CREPP-PLOEMEUR/Projet_motogodille/README.md

<!--# Motogodille -->
<!--$ Freecad-->
<!--$ C++ -->
<!--% Un projet de motorisation d'annexe de bateau -->

# Projet de motogodille

Un projet de motorisation d'annexe de bateau.

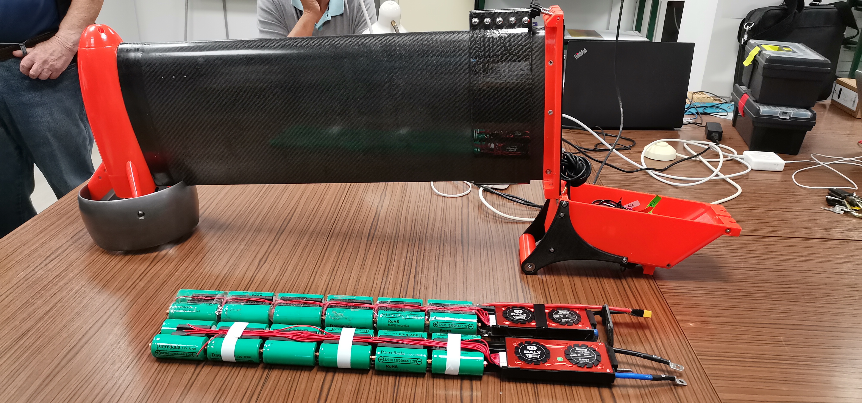
[picture p1: Images/1.jpg]
