CREPP-PLOEMEUR/Projet_motogodille/V0_prototype/schéma_BMS_32700-controleur_julien.pptx

Prise
chargeur

+

+

32700

32700

32700

32700

32700

BMS 10S 36V

C-

P-

32700

32700

32700

32700

32700

B-

+

Contrôleur julien
36V 30A

Moteur
36V
1500W
(42A)

Bouton
Inverseur de
rotation

Potentiomètre
variateur
vitesse
