CREPP-PLOEMEUR/Projet_motogodille/V0_prototype/schéma_BMS_32700.pptx

I 0 II

88.8

+

Contrôleur 36V 30A

+

Moteur
36V
1500W
(42A)

32700

32700

32700

32700

32700

32700

32700

32700

32700

+

+

32700

BMS 10S 36V
