CREPP-PLOEMEUR/Projet_motogodille/V0_prototype/schéma_BMS.pdf

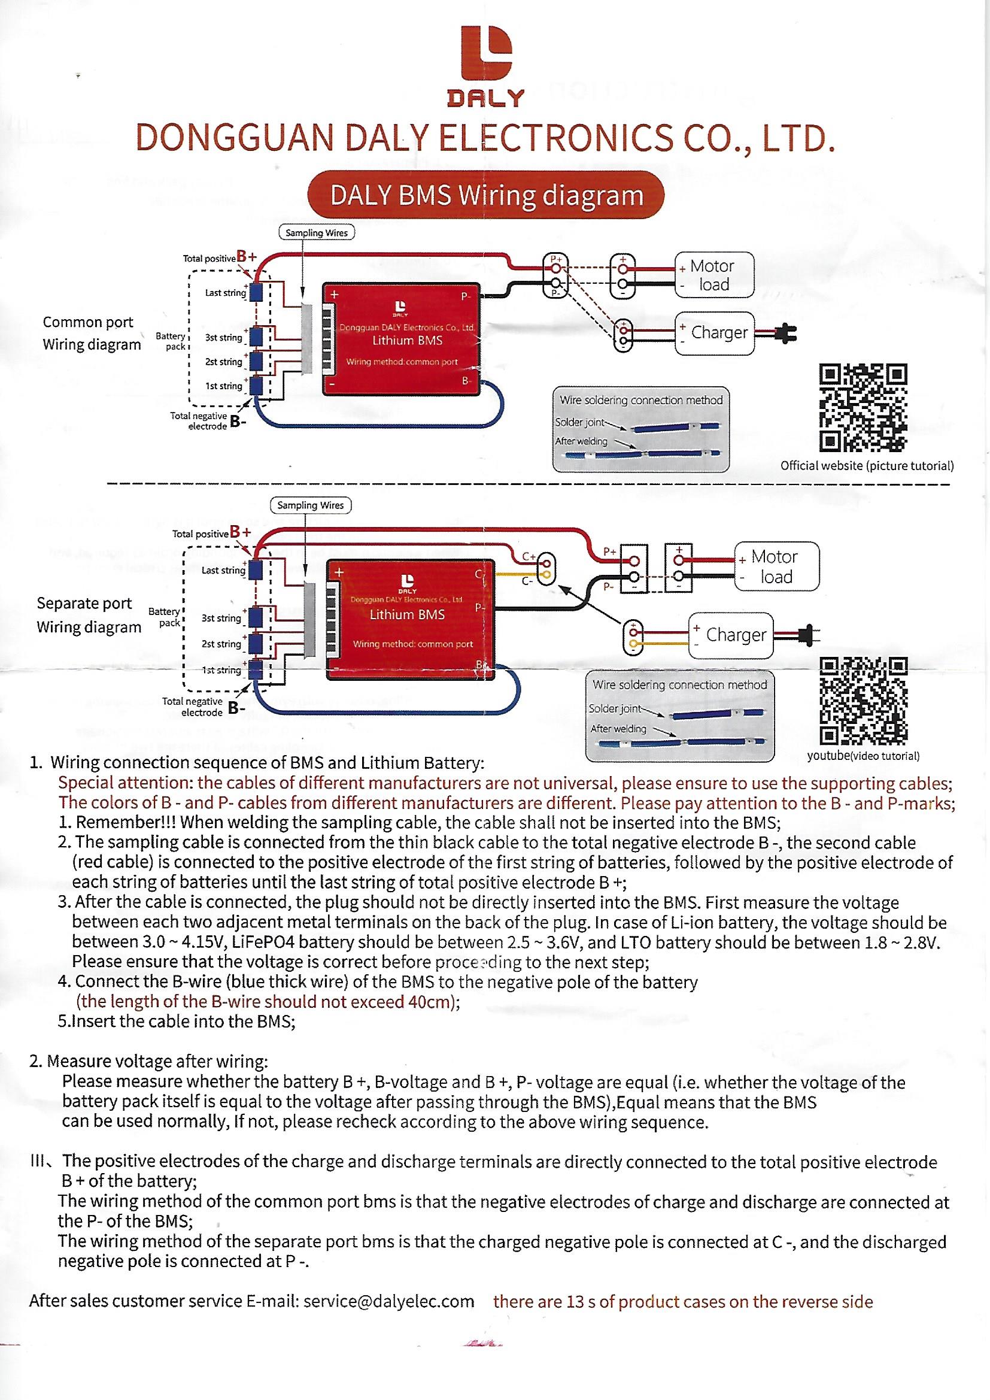
[picture p2: page 1]
