CREPP-PLOEMEUR/Projet_motogodille/V1/photo_video/IMG_5900.jpg

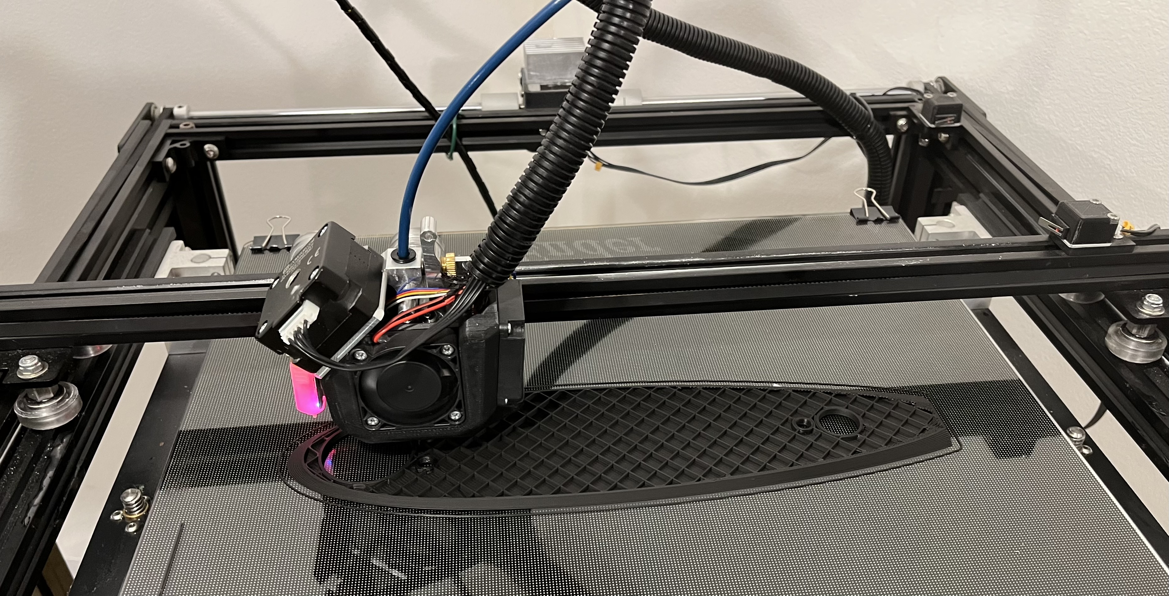
V1/photo_video/IMG_5900.jpg
