CREPP-PLOEMEUR/Projet_motogodille/V1/photo_video/IMG_5931.jpg

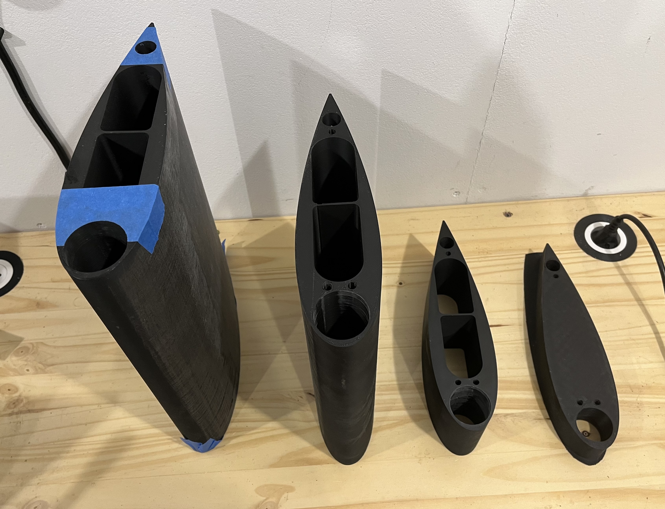
V1/photo_video/IMG_5931.jpg
