CREPP-PLOEMEUR/Projet_motogodille/V1/photo_video/IMG_5932.jpg

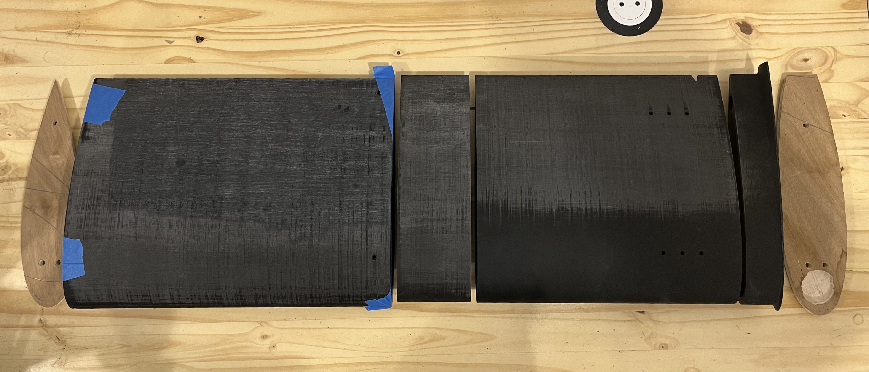
V1/photo_video/IMG_5932.jpg
