CREPP-PLOEMEUR/Projet_motogodille/V1/photo_video/IMG_5934.jpg

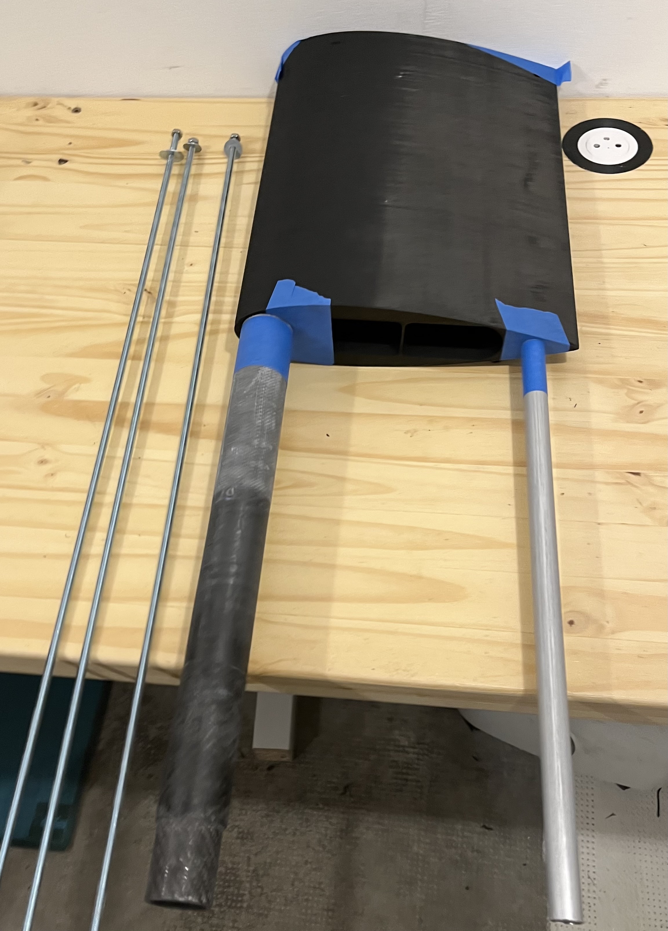
V1/photo_video/IMG_5934.jpg
