CREPP-PLOEMEUR/Projet_motogodille/V1/photo_video/IMG_5938.jpg

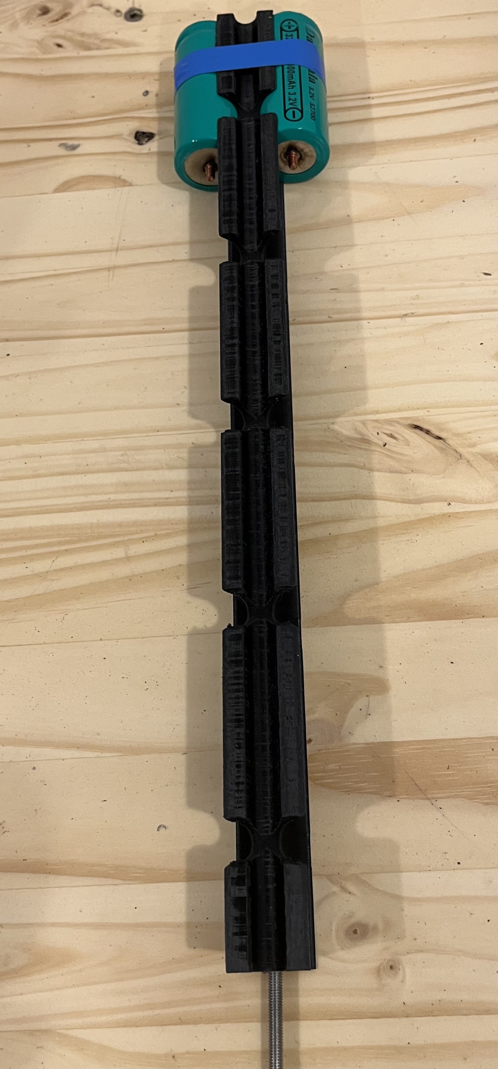
V1/photo_video/IMG_5938.jpg
