CREPP-PLOEMEUR/Projet_motogodille/V1/photo_video/IMG_5939.jpg

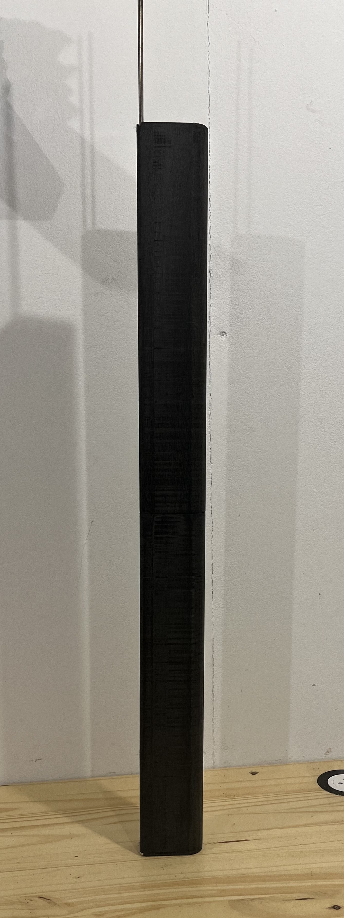
V1/photo_video/IMG_5939.jpg
