CREPP-PLOEMEUR/Projet_motogodille/V1/photo_video/IMG_5940.jpg

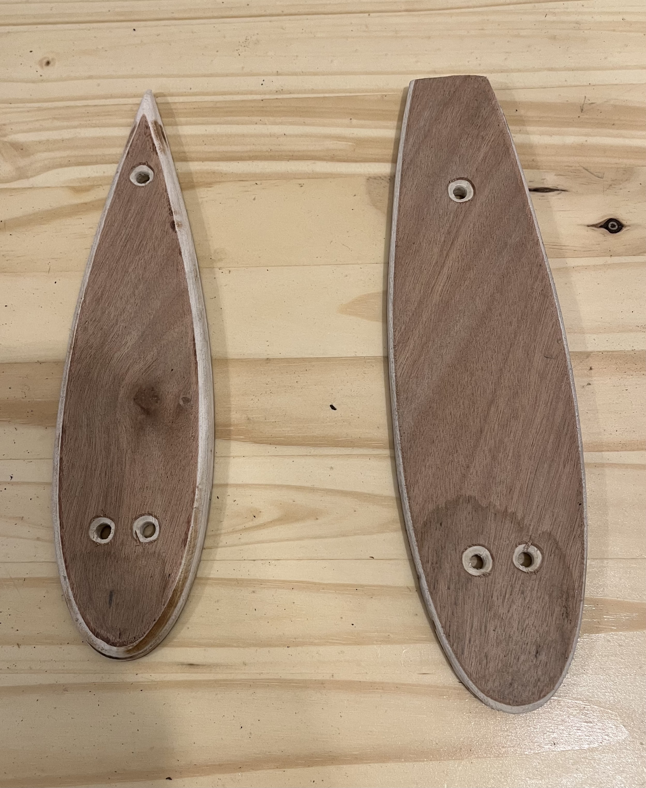
V1/photo_video/IMG_5940.jpg
