CREPP-PLOEMEUR/Projet_motogodille/V1/photo_video/IMG_5956.jpg

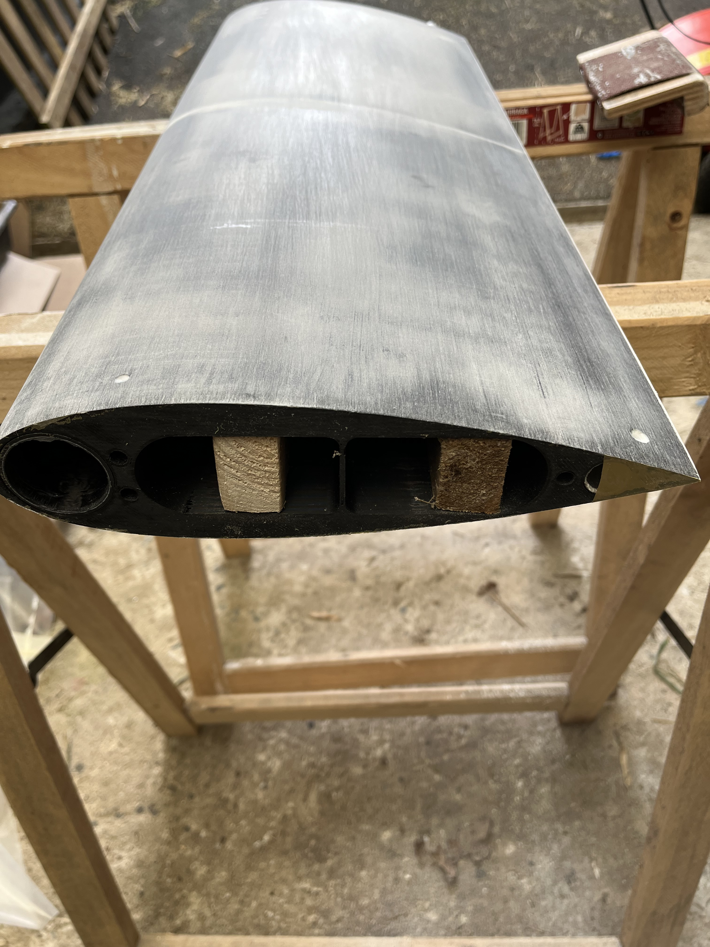
V1/photo_video/IMG_5956.jpg
