CREPP-PLOEMEUR/Projet_motogodille/V1/photo_video/IMG_5966.jpg

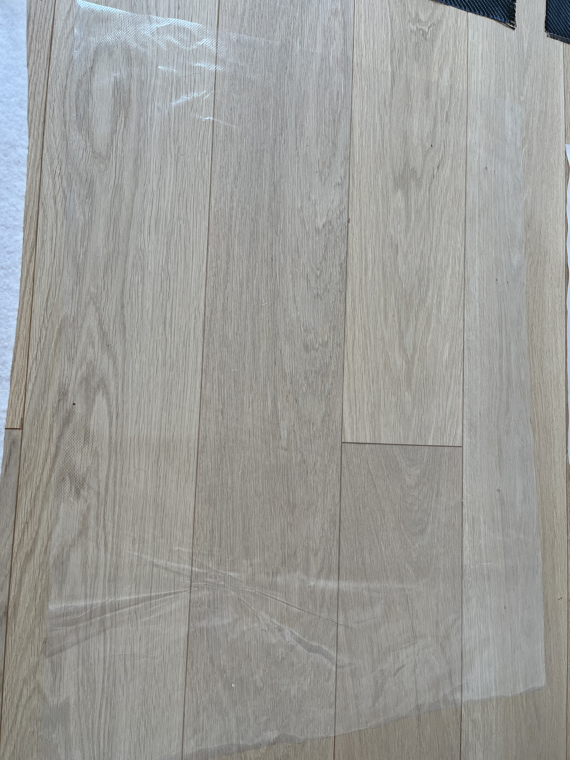
V1/photo_video/IMG_5966.jpg
