CREPP-PLOEMEUR/Projet_motogodille/V1/photo_video/IMG_5988.jpg

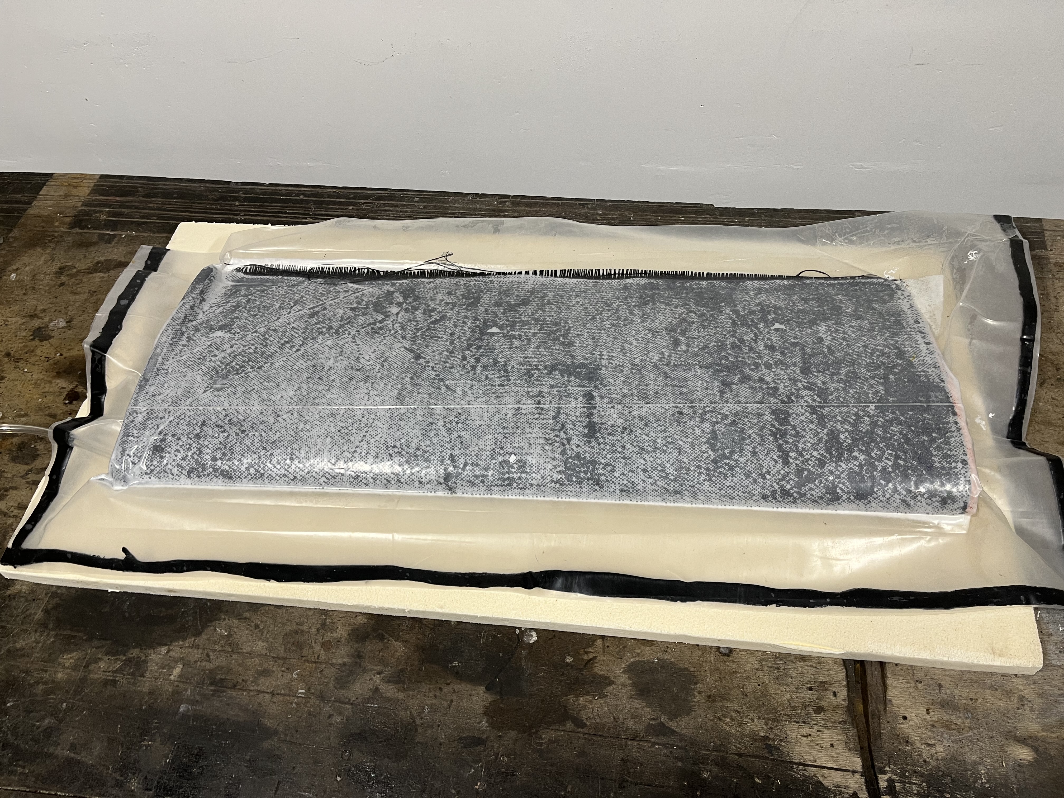
V1/photo_video/IMG_5988.jpg
