CREPP-PLOEMEUR/Projet_motogodille/V1/photo_video/IMG_7340.jpg

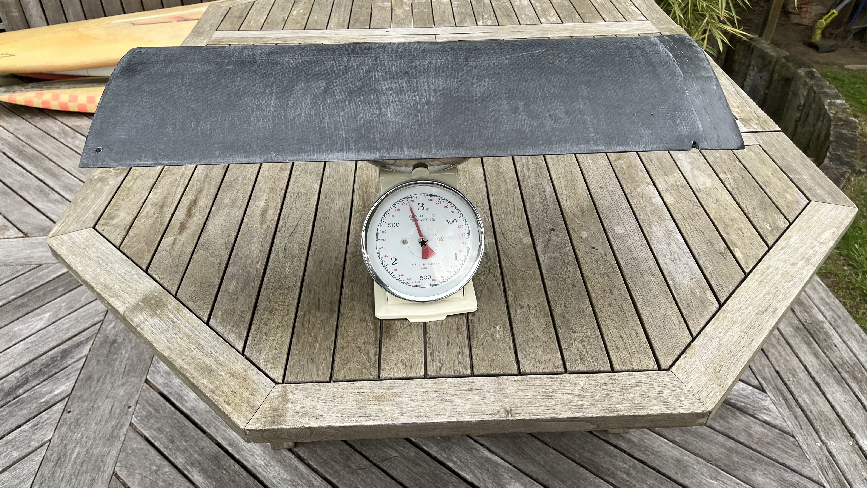
V1/photo_video/IMG_7340.jpg
