CREPP-PLOEMEUR/Projet_motogodille/V1/photo_video/IMG_7341.jpg

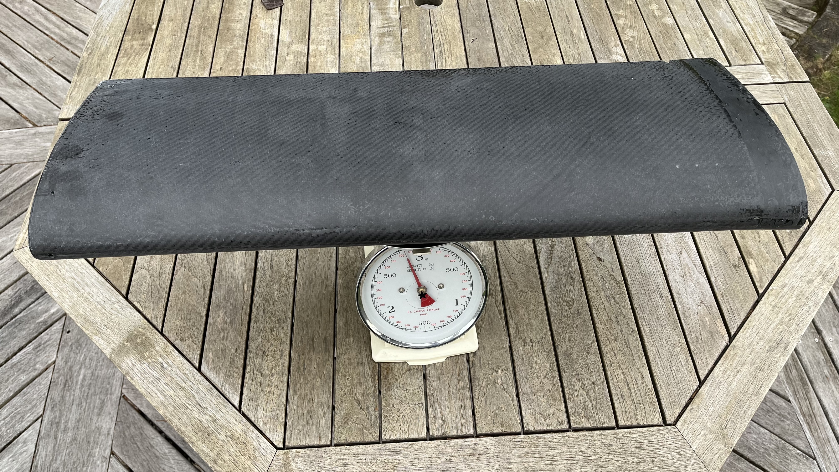
V1/photo_video/IMG_7341.jpg
