CREPP-PLOEMEUR/Projet_motogodille/V1/photo_video/IMG_7342.jpg

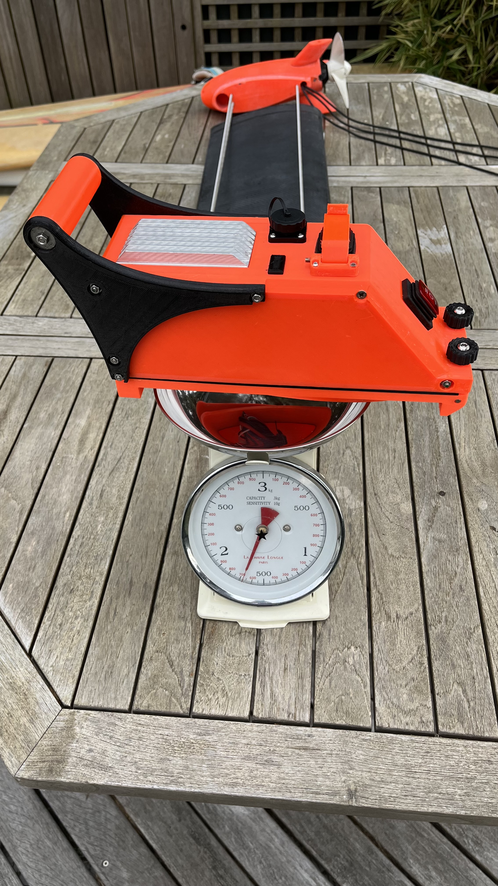
V1/photo_video/IMG_7342.jpg
