CREPP-PLOEMEUR/Projet_motogodille/V1/photo_video/IMG_7344.jpg

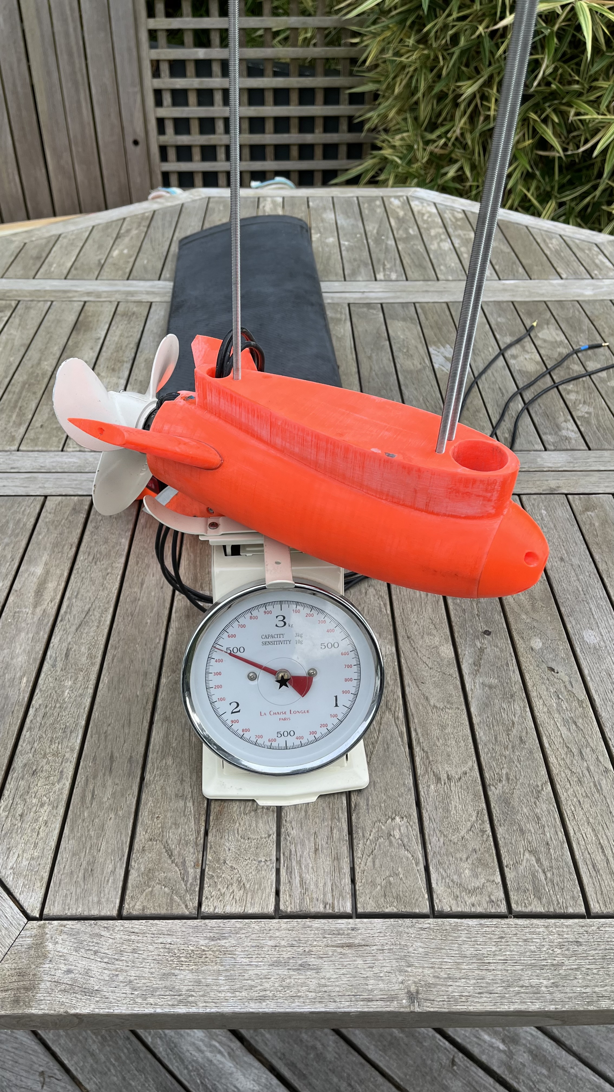
V1/photo_video/IMG_7344.jpg
