CREPP-PLOEMEUR/Projet_motogodille/V1/photo_video/IMG_7346.jpg

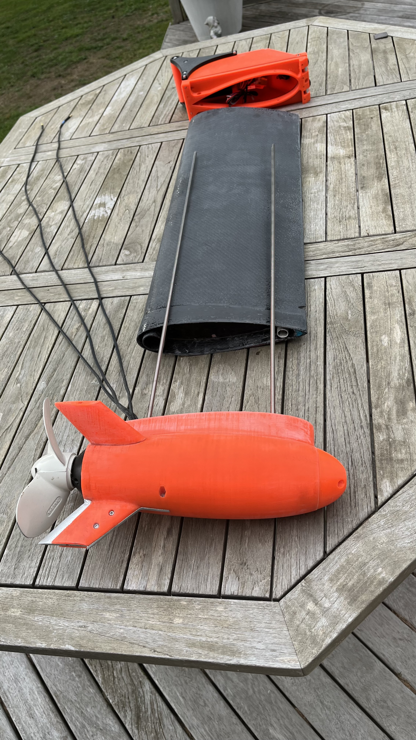
V1/photo_video/IMG_7346.jpg
