CREPP-PLOEMEUR/Projet_motogodille/V1/photo_video/IMG_7348.jpg

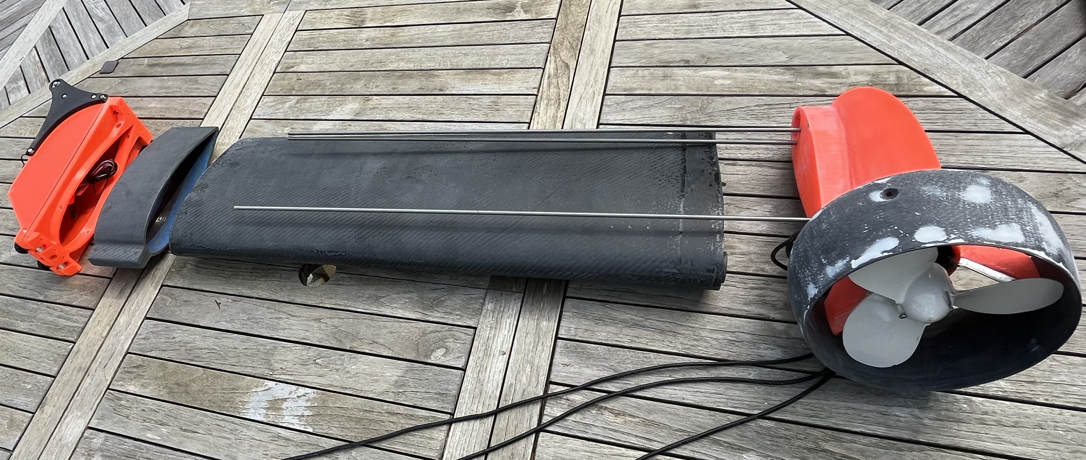
V1/photo_video/IMG_7348.jpg
