CREPP-PLOEMEUR/Projet_motogodille/V1/photo_video/IMG_7349.jpg

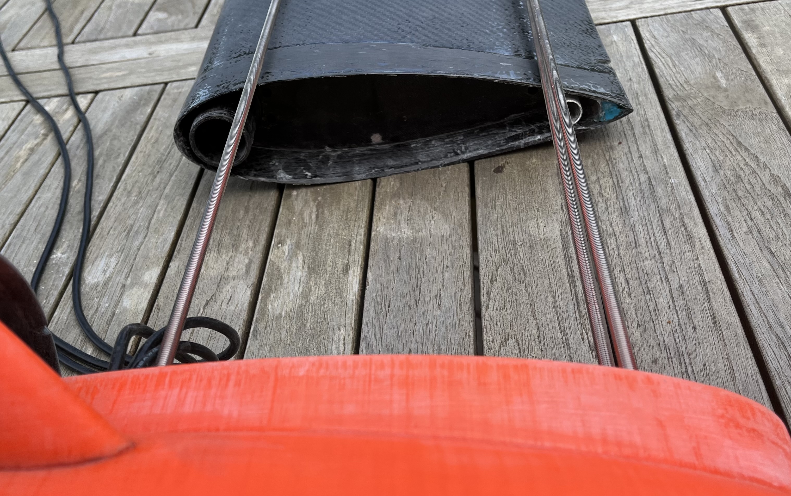
V1/photo_video/IMG_7349.jpg
