CREPP-PLOEMEUR/Projet_motogodille/V1/photo_video/IMG_7351.jpg

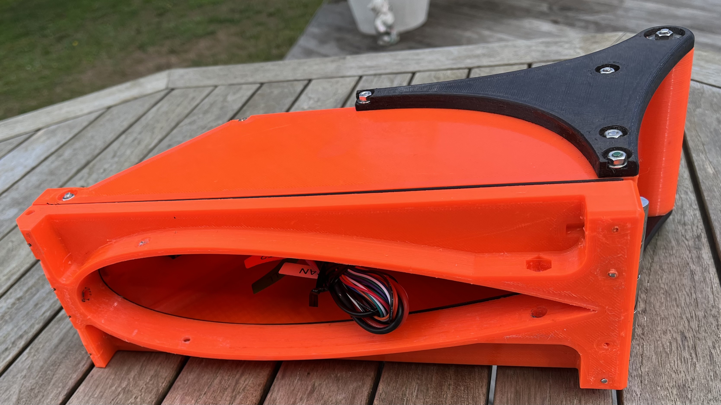
V1/photo_video/IMG_7351.jpg
