CREPP-PLOEMEUR/Projet_motogodille/V1/dossier de conception_nomenclature_pert/schéma_BMS_32700_motogodille_2_V2.pptx

Charge batterie A

+

BMS 12S 36V

P-

B-

+

+

32700

32700

32700

32700

32700

32700

Batterie A

32700

32700

32700

32700

32700

32700

+

+

+

P-

BMS 12S 36V

B-

+

32700

32700

32700

32700

32700

32700

Charge batterie B

Batterie B

+

32700

32700

32700

32700

32700

32700

Moteur
36V
1500W
(60A)

+

Alimentation ext

Contrôleur
40V 100A

Bouton Inverseur de rotation

Potentiomètre
variateur
vitesse
