CREPP-PLOEMEUR/Projet_motogodille/(list of files, cad)

Other CAD files:
V0_prototype/bouchon_vidange_1.FCStd
V1/freecad/motogodille_2_tierce.FCStd
V0_prototype/ressort_rappel.FCStd
V1/freecad/boitier_batterie_BMS_150.FCStd
V0_prototype/rondelle_potentiometre.FCStd
V1/freecad/haut_MTG2_tierce.FCStd
V0_prototype/poignée de gaz_1.FCStd
V0_prototype/tirette.FCStd
V0_prototype/poignée_transport.FCStd
V0_prototype/passe_cable_3.FCStd
V0_prototype/écrou_poignée.FCStd
V0_prototype/rondelle_tirette.FCStd
V0_prototype/flasque_tube_32.FCStd
