CREPP-PLOEMEUR/Projet_motogodille/V1/dossier de conception_nomenclature_pert/schéma_BMS_32700_motogodille_2_V2.pdf

+

-B -

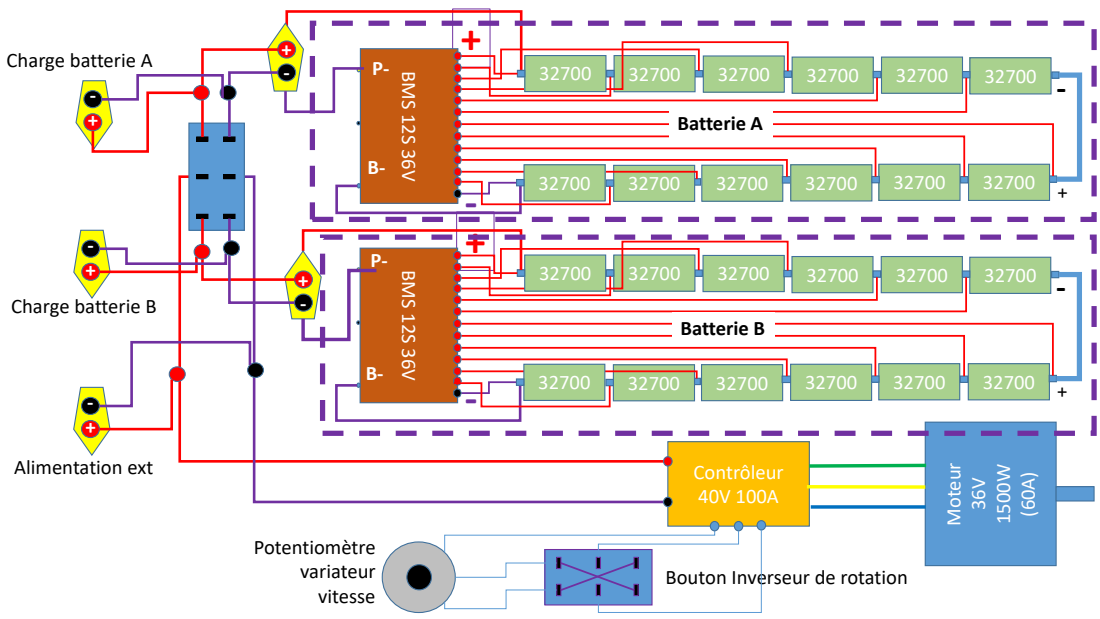
[picture p68: page 1]
Contrôleur 40V 100A; Moteur; BMS 12S 36V; Potentiomètre variateur vitesse; Charge batterie; Batterie A; Batterie B; Alimentation ext +-

Bouton Inverseur de rotation
