CREPP-PLOEMEUR/Projet_motogodille/V0_prototype/schéma_BMS_32700-controleur_julien.pdf

+

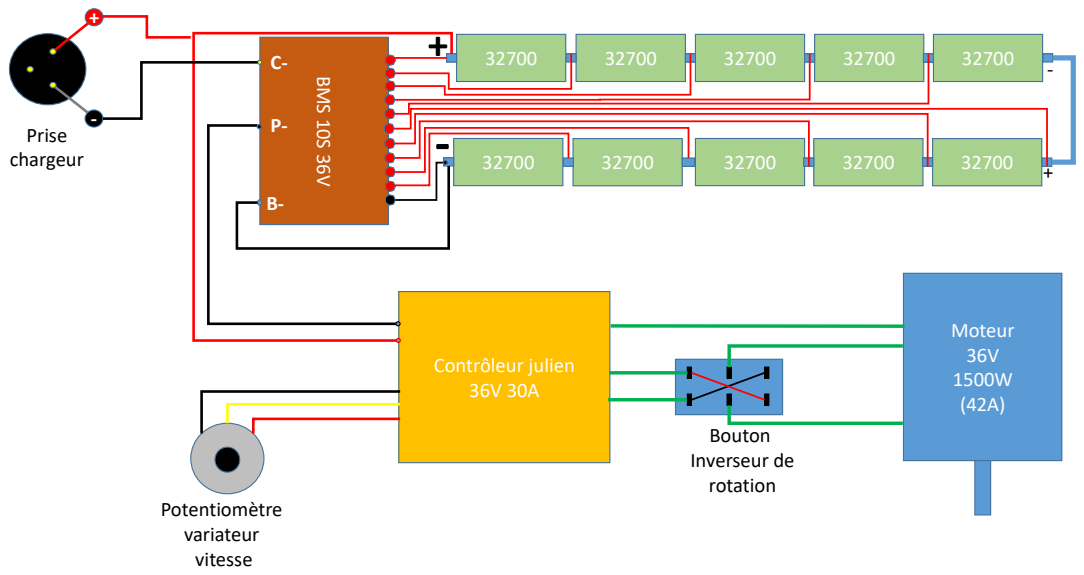
[picture p69: page 1]
Contrôleur julien 36V 30A; Moteur 36V 1500W (42A); BMS 10S 36V; Bouton Inverseur de rotation; Prise chargeur; Potentiomètre variateur vitesse
