CREPP-PLOEMEUR/Projet_motogodille/V1/dossier de conception_nomenclature_pert/fixation_tableau_MTG2.pdf

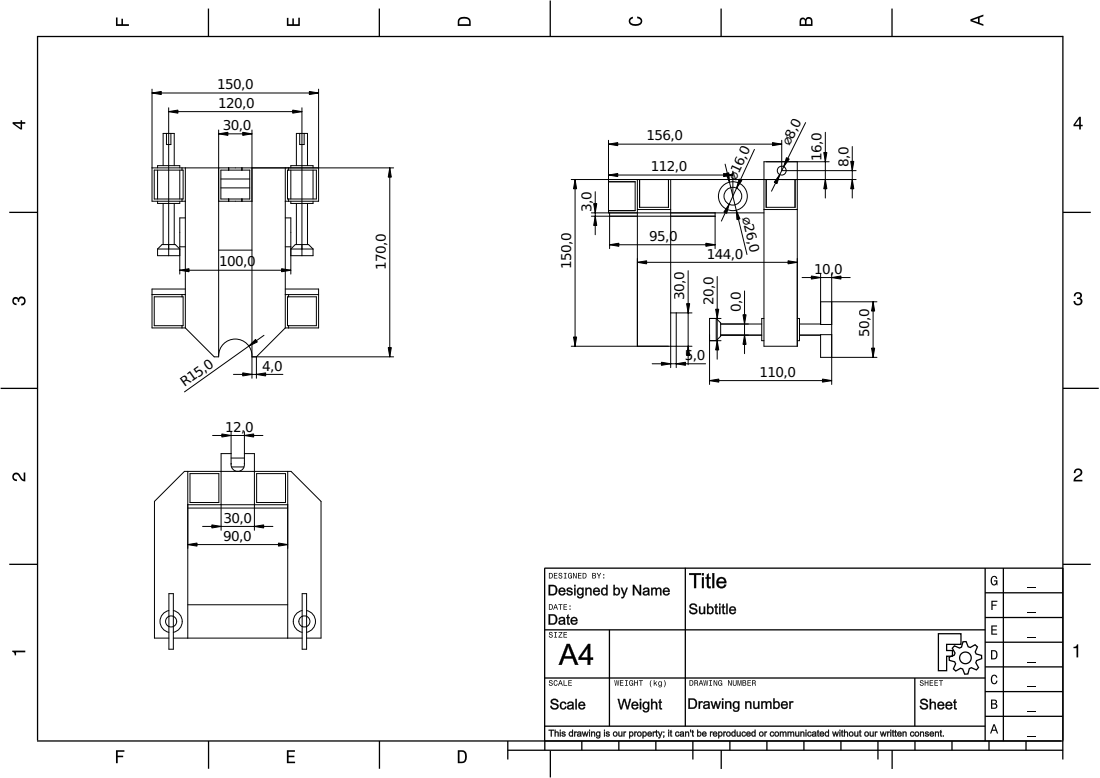
[picture p70: page 1]
