CREPP-PLOEMEUR/Projet_motogodille/V1/dossier de conception_nomenclature_pert/pivot.pdf

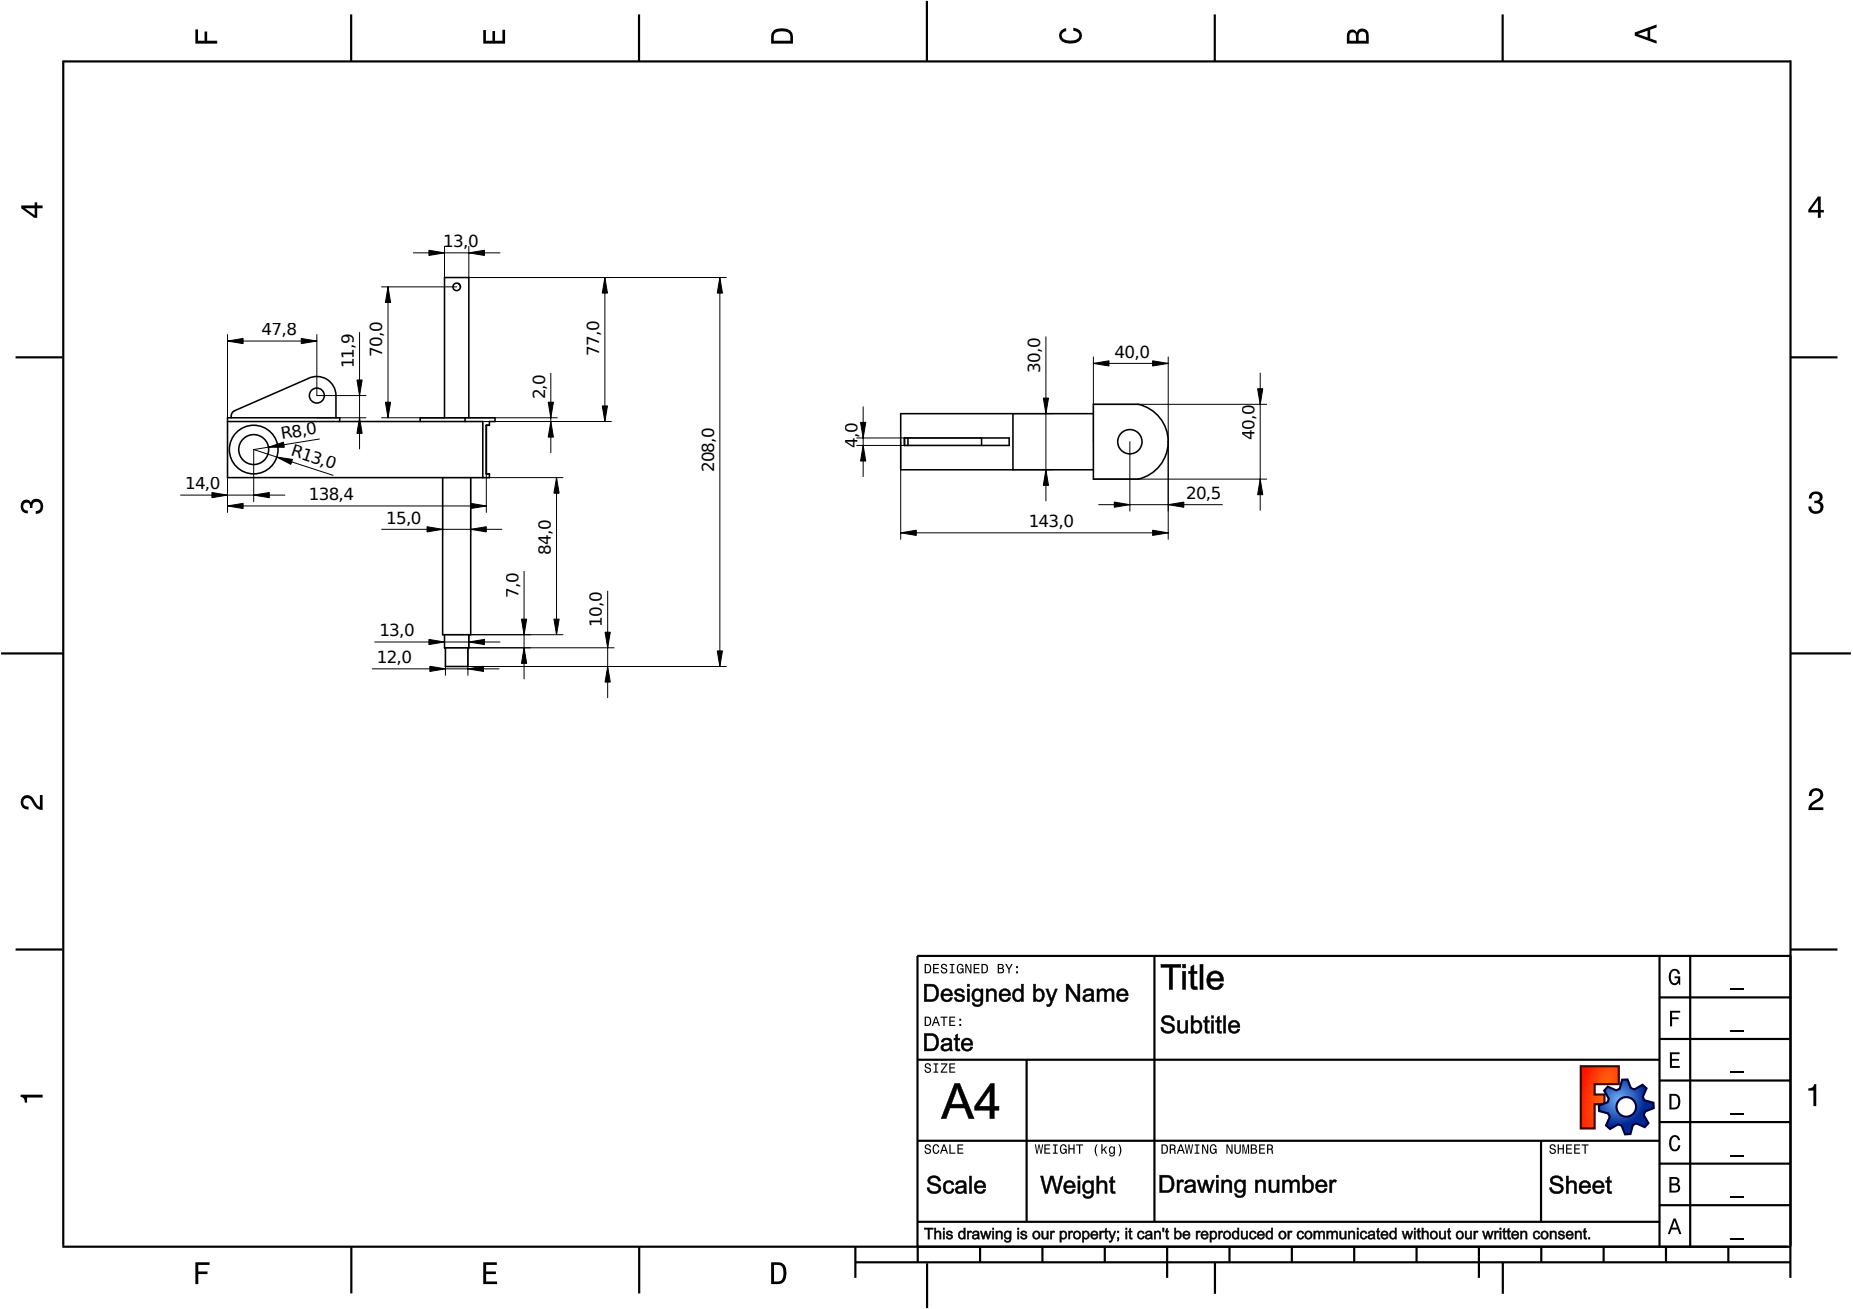
[picture p71: page 1]
