CREPP-PLOEMEUR/Projet_motogodille/V1/dossier de conception_nomenclature_pert/plaque_alu.pdf

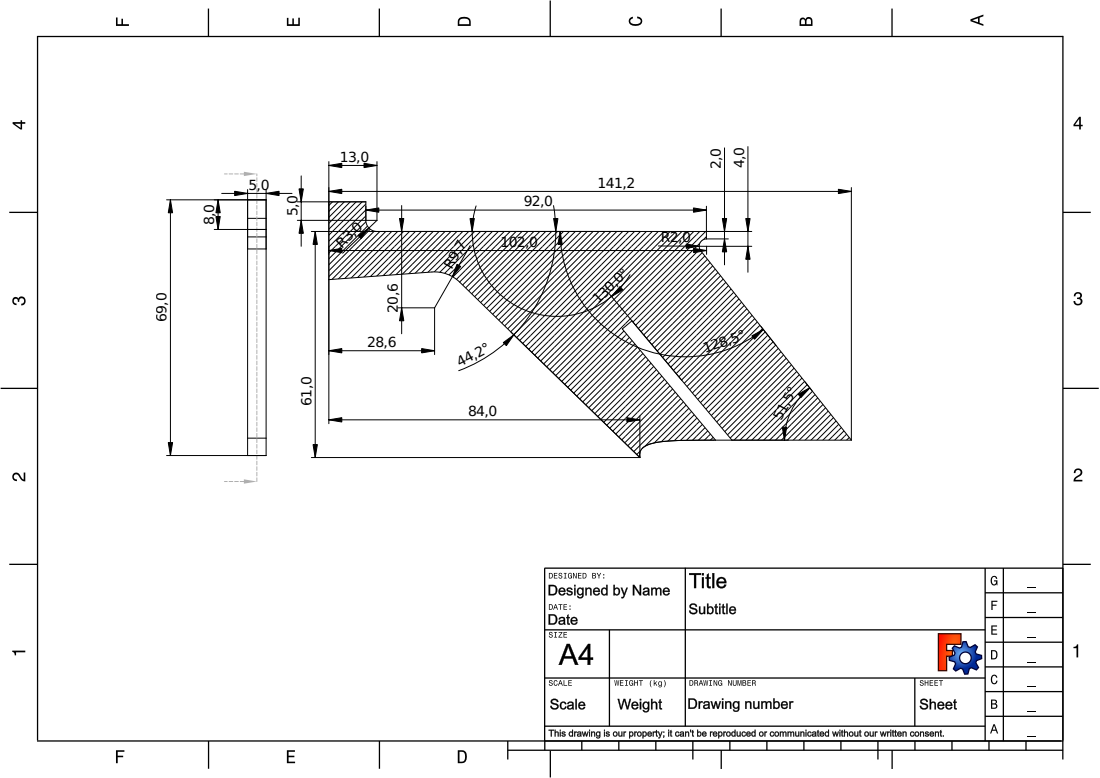
[picture p72: page 1]
