CREPP-PLOEMEUR/Projet_motogodille/V1/dossier de conception_nomenclature_pert/profil_bis.pdf

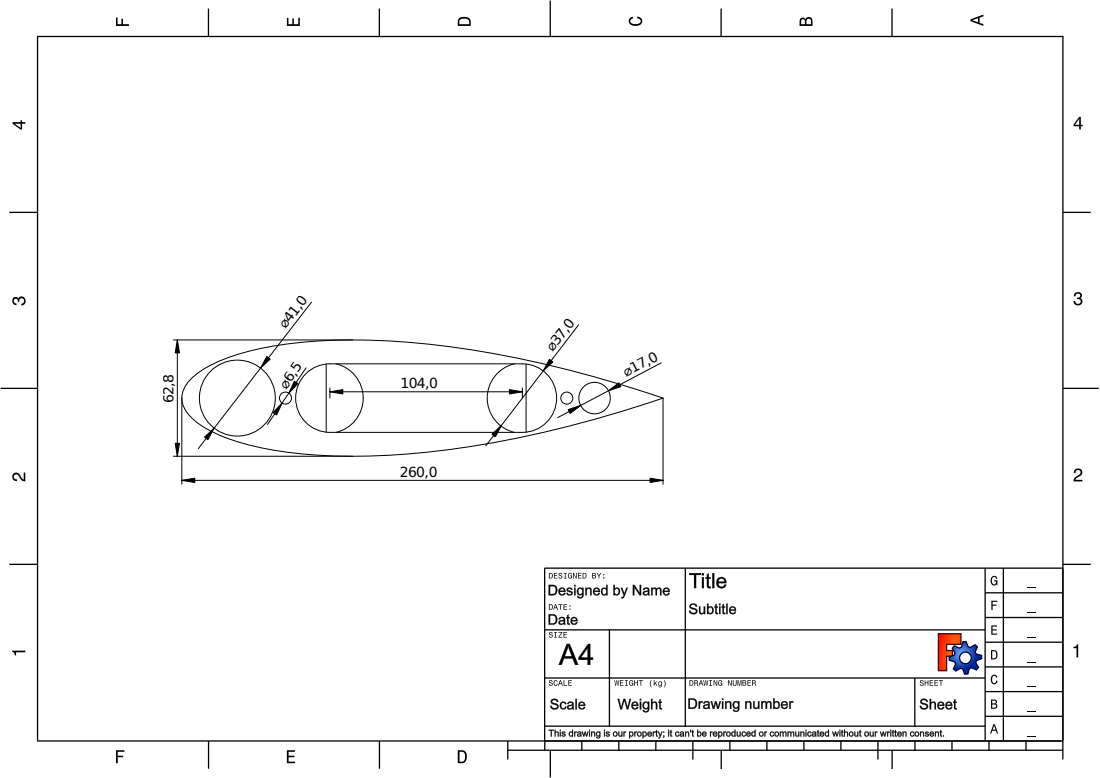
[picture p73: page 1]
