CREPP-PLOEMEUR/Projet_motogodille/(commit log)

2023-12-18 add V0
    [bouchon_vidange_1.FCStd, flasque_tube_32.FCStd, passe_cable_3.FCStd, poignée de gaz_1.FCStd, poignée_transport.FCStd, ressort_rappel.FCStd, rondelle_potentiometre.FCStd, rondelle_tirette.FCStd]
2023-12-18 Add LFS
    [bouchon_vidange_1.FCStd, flasque_tube_32.FCStd, passe_cable_3.FCStd, poignée de gaz_1.FCStd, poignée_transport.FCStd, ressort_rappel.FCStd, rondelle_potentiometre.FCStd, rondelle_tirette.FCStd]
2023-12-18 Add all files
    [boitier_batterie_BMS_150.FCStd, devis de masse motogodille_2_tierce.xlsx, haut_MTG2_tierce.FCStd, motogodille_2_tierce.FCStd]
